theorlangur/smart_watering/pcb/tps61089_layout_example.png

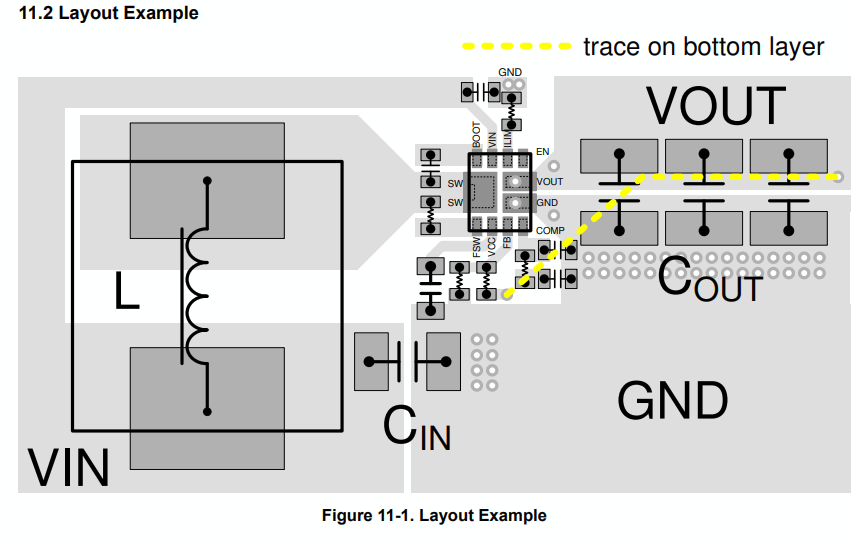
pcb/tps61089_layout_example.png
