theorlangur/smart_watering/pcb/usb-to-uart_swd.png

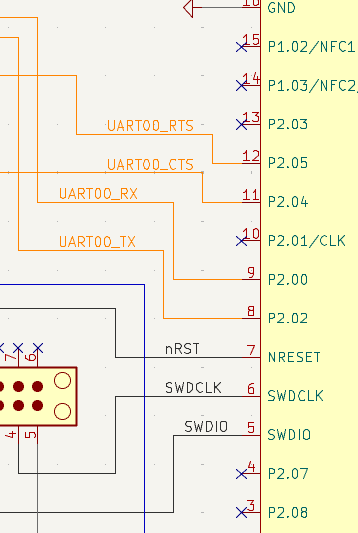
pcb/usb-to-uart_swd.png
