theorlangur/smart_watering/pcb/production/bom.csv

Designator | Footprint | Quantity | Value | LCSC Part #
AEM_CONN_DATA1, AEM_CONN_PWR1 | JST_PH_B6B-PH-K_1x06_P2.00mm_Vertical | 2 | Conn_01x06
AEM_USB_J1 | JST_PH_B2B-PH-K_1x02_P2.00mm_Vertical | 1 | Conn_01x02
BAT_C1, BOOST_9V_C4, BTN_C1, BTN_C2, BTN_C3, MCU_C2 | 0805 | 6 | 100nF
BAT_IC1 | S-82A1A | 1 | S-82A1AAG-I6T1U
BAT_J1 | JST_PH_B2B-PH-K_1x02_P2.00mm_Vertical | 1 | BAT 18650x2
BAT_Q1 | CSD83325L | 1 | CSD83325L
BAT_R1 | 0805 | 1 | 330_O
BAT_R2 | 0805 | 1 | 470_O
BAT_R3 | 0805 | 1 | 5mO
BOOST_9V_C1, BOOST_9V_C2 | 0805 | 2 | 22u
BOOST_9V_C3 | 0805 | 1 | 2.2uF
BOOST_9V_C5 | 0805 | 1 | 4.7nF
BOOST_9V_C6, BOOST_9V_C7, BOOST_9V_C8 | 0805 | 3 | 22uF
BOOST_9V_L1 | IND_EXLA1V0606_EAT | 1 | 1.8uH
BOOST_9V_R1 | 0805 | 1 | 681kO
BOOST_9V_R2 | 0805 | 1 | 107kO
BOOST_9V_R3 | 0805 | 1 | 301kO
BOOST_9V_R4 | 0805 | 1 | 127kO
BOOST_9V_R5 | 0805 | 1 | 17.4kO
BOOST_IC1 | TPS61089 | 1 | TPS61089RNRR
BTN1 | JST_PH_B2B-PH-K_1x02_P2.00mm_Vertical | 1 | Boot
BTN2 | JST_PH_B2B-PH-K_1x02_P2.00mm_Vertical | 1 | ZB
BTN3 | JST_PH_B2B-PH-K_1x02_P2.00mm_Vertical | 1 | CTRL
BTN_R1, BTN_R2, BTN_R3, PUMP_R2, PUMP_R3, UART_R1, UART_R2, USB_R4 | 0805 | 8 | 1kO
IC1 | LDL1117S33R | 1 | LDL1117S33R
MCU_C1, PRESSURE_C1, USB_C1, USB_C2 | 0805 | 4 | 10uF
MCU_IC1 | Laird, BL54L15 Module, Platform Side | 1 | ezurio_bl54l15_453-00001R
MCU_Y1 | Wurth-XTAL-830050789 | 1 | Wurth 830050789
PRESSURE_C2, SENSE_C1, SENSE_C2, SENSE_C3, UART_C1, UART_C2, USB_C3, USB_C4 | 0805 | 8 | 1uF
PRESSURE_C3, PUMP_C1 | 0805 | 2 | 10nF
PRESSURE_IC1 | LDL1117S50R | 1 | LDL1117S50R
PRESSURE_R1, PRESSURE_R2 | 0805 | 2 | 10kO
PRESSURE_U1 | JST_PH_B3B-PH-K_1x03_P2.00mm_Vertical | 1 | ~
PUMP_R1, USB_R3 | 0805 | 2 | 100kO
PUMP_U1 | JST_PH_B5B-PH-K_1x05_P2.00mm_Vertical | 1 | ~
SENSE_LOAD1, SENSE_LOAD2, SENSE_LOAD3 | TPS22917DBVR | 3 | TPS22917DBVR
SENSE_LOAD_QOD1, SENSE_LOAD_QOD2, SENSE_LOAD_QOD3 | 0805 | 3 | 680_O
SENSE_S1 | JST_SH_BM04B-SRSS-TB_1x04-1MP_P1.00mm_Vertical | 1 | ~
SENSE_U2 | JST_PH_B3B-PH-K_1x03_P2.00mm_Vertical | 1 | S1
SENSE_U3 | JST_PH_B3B-PH-K_1x03_P2.00mm_Vertical | 1 | S2
SENSE_U4 | JST_PH_B3B-PH-K_1x03_P2.00mm_Vertical | 1 | S3
SOIL_D1, SOIL_D2, SOIL_D3, USB_D1 | SOT-23-6 | 4 | USBLC6-2SC6
SWD_J1 | IDC Box Header 2x5 1.27 | 1 | IDC Box Header
UART_U1 | MSOP-10_3x3mm_P0.5mm | 1 | CH340E
USB_J1 | USB_C_Receptacle_GCT_USB4105-xx-A_16P_TopMnt_Horizontal | 1 | USB_C_Receptacle_USB2.0_16P
USB_R1, USB_R2 | 0805 | 2 | 5k1_O
