theorlangur/smart_watering/pcb/watering_4layer.csv

Id | Designator | Footprint | Quantity | Designation | Supplier and ref
1 | AEM_CONN_DATA1, AEM_CONN_PWR1 | JST_PH_B6B-PH-K_1x06_P2.00mm_Vertical | 2 | Conn_01x06
2 | AEM_USB_J1 | JST_PH_B2B-PH-K_1x02_P2.00mm_Vertical | 1 | Conn_01x02
3 | BAT_C1, BOOST_9V_C4, BTN_C1, BTN_C2, BTN_C3, MCU_C2 | C_0805_2012Metric | 6 | 100nF
4 | BAT_IC1 | S-82A1A | 1 | S-82A1AAG-I6T1U
5 | BAT_J1 | JST_PH_B2B-PH-K_1x02_P2.00mm_Vertical | 1 | BAT 18650x2
6 | BAT_Q1 | CSD83325L | 1 | CSD83325L
7 | BAT_R1 | R_0805_2012Metric | 1 | 330_O
8 | BAT_R2 | R_0805_2012Metric | 1 | 470_O
9 | BAT_R3 | R_0805_2012Metric | 1 | 5mO
10 | BOOST_9V_C1, BOOST_9V_C2 | C_0805_2012Metric | 2 | 22u
11 | BOOST_9V_C3 | C_0805_2012Metric | 1 | 2.2uF
12 | BOOST_9V_C5 | C_0805_2012Metric | 1 | 4.7nF
13 | BOOST_9V_C6, BOOST_9V_C7, BOOST_9V_C8 | C_0805_2012Metric | 3 | 22uF
14 | BOOST_9V_L1 | IND_EXLA1V0606_EAT | 1 | 1.8uH
15 | BOOST_9V_R1 | R_0805_2012Metric | 1 | 681kO
16 | BOOST_9V_R2 | R_0805_2012Metric | 1 | 107kO
17 | BOOST_9V_R3 | R_0805_2012Metric | 1 | 301kO
18 | BOOST_9V_R4 | R_0805_2012Metric | 1 | 127kO
19 | BOOST_9V_R5 | R_0805_2012Metric | 1 | 17.4kO
20 | BOOST_IC1 | TPS61089 | 1 | TPS61089RNRR
21 | BTN1 | JST_PH_B2B-PH-K_1x02_P2.00mm_Vertical | 1 | Boot
22 | BTN2 | JST_PH_B2B-PH-K_1x02_P2.00mm_Vertical | 1 | ZB
23 | BTN3 | JST_PH_B2B-PH-K_1x02_P2.00mm_Vertical | 1 | CTRL
24 | BTN_R1, BTN_R2, BTN_R3, PUMP_R2, PUMP_R3, UART_R1, UART_R2, USB_R4 | R_0805_2012Metric | 8 | 1kO
25 | IC1 | LDL1117S33R | 1 | LDL1117S33R
26 | MCU_C1, PRESSURE_C1, USB_C1, USB_C2 | C_0805_2012Metric | 4 | 10uF
27 | MCU_IC1 | Laird, BL54L15 Module, Platform Side | 1 | ezurio_bl54l15_453-00001R
28 | MCU_Y1 | Wurth-XTAL-830050789 | 1 | Wurth 830050789
29 | PRESSURE_C2, SENSE_C1, SENSE_C2, SENSE_C3, UART_C1, UART_C2, USB_C3, USB_C4 | C_0805_2012Metric | 8 | 1uF
30 | PRESSURE_C3, PUMP_C1 | C_0805_2012Metric | 2 | 10nF
31 | PRESSURE_IC1 | LDL1117S50R | 1 | LDL1117S50R
32 | PRESSURE_R1, PRESSURE_R2 | R_0805_2012Metric | 2 | 10kO
33 | PRESSURE_U1 | JST_PH_B3B-PH-K_1x03_P2.00mm_Vertical | 1 | ~
34 | PUMP_R1, USB_R3 | R_0805_2012Metric | 2 | 100kO
35 | PUMP_U1 | JST_PH_B5B-PH-K_1x05_P2.00mm_Vertical | 1 | ~
36 | SENSE_LOAD1, SENSE_LOAD2, SENSE_LOAD3 | TPS22917DBVR | 3 | TPS22917DBVR
37 | SENSE_LOAD_QOD1, SENSE_LOAD_QOD2, SENSE_LOAD_QOD3 | R_0805_2012Metric | 3 | 680_O
38 | SENSE_S1 | JST_SH_BM04B-SRSS-TB_1x04-1MP_P1.00mm_Vertical | 1 | ~
39 | SENSE_U2 | JST_PH_B3B-PH-K_1x03_P2.00mm_Vertical | 1 | S1
40 | SENSE_U3 | JST_PH_B3B-PH-K_1x03_P2.00mm_Vertical | 1 | S2
41 | SENSE_U4 | JST_PH_B3B-PH-K_1x03_P2.00mm_Vertical | 1 | S3
42 | SOIL_D1, SOIL_D2, SOIL_D3, USB_D1 | SOT-23-6 | 4 | USBLC6-2SC6
43 | SWD_J1 | IDC Box Header 2x5 1.27 | 1 | IDC Box Header
44 | UART_U1 | MSOP-10_3x3mm_P0.5mm | 1 | CH340E
45 | USB_J1 | USB_C_Receptacle_GCT_USB4105-xx-A_16P_TopMnt_Horizontal | 1 | USB_C_Receptacle_USB2.0_16P
46 | USB_R1, USB_R2 | R_0805_2012Metric | 2 | 5k1_O
