theorlangur/smart_watering/pcb/board_back.pdf

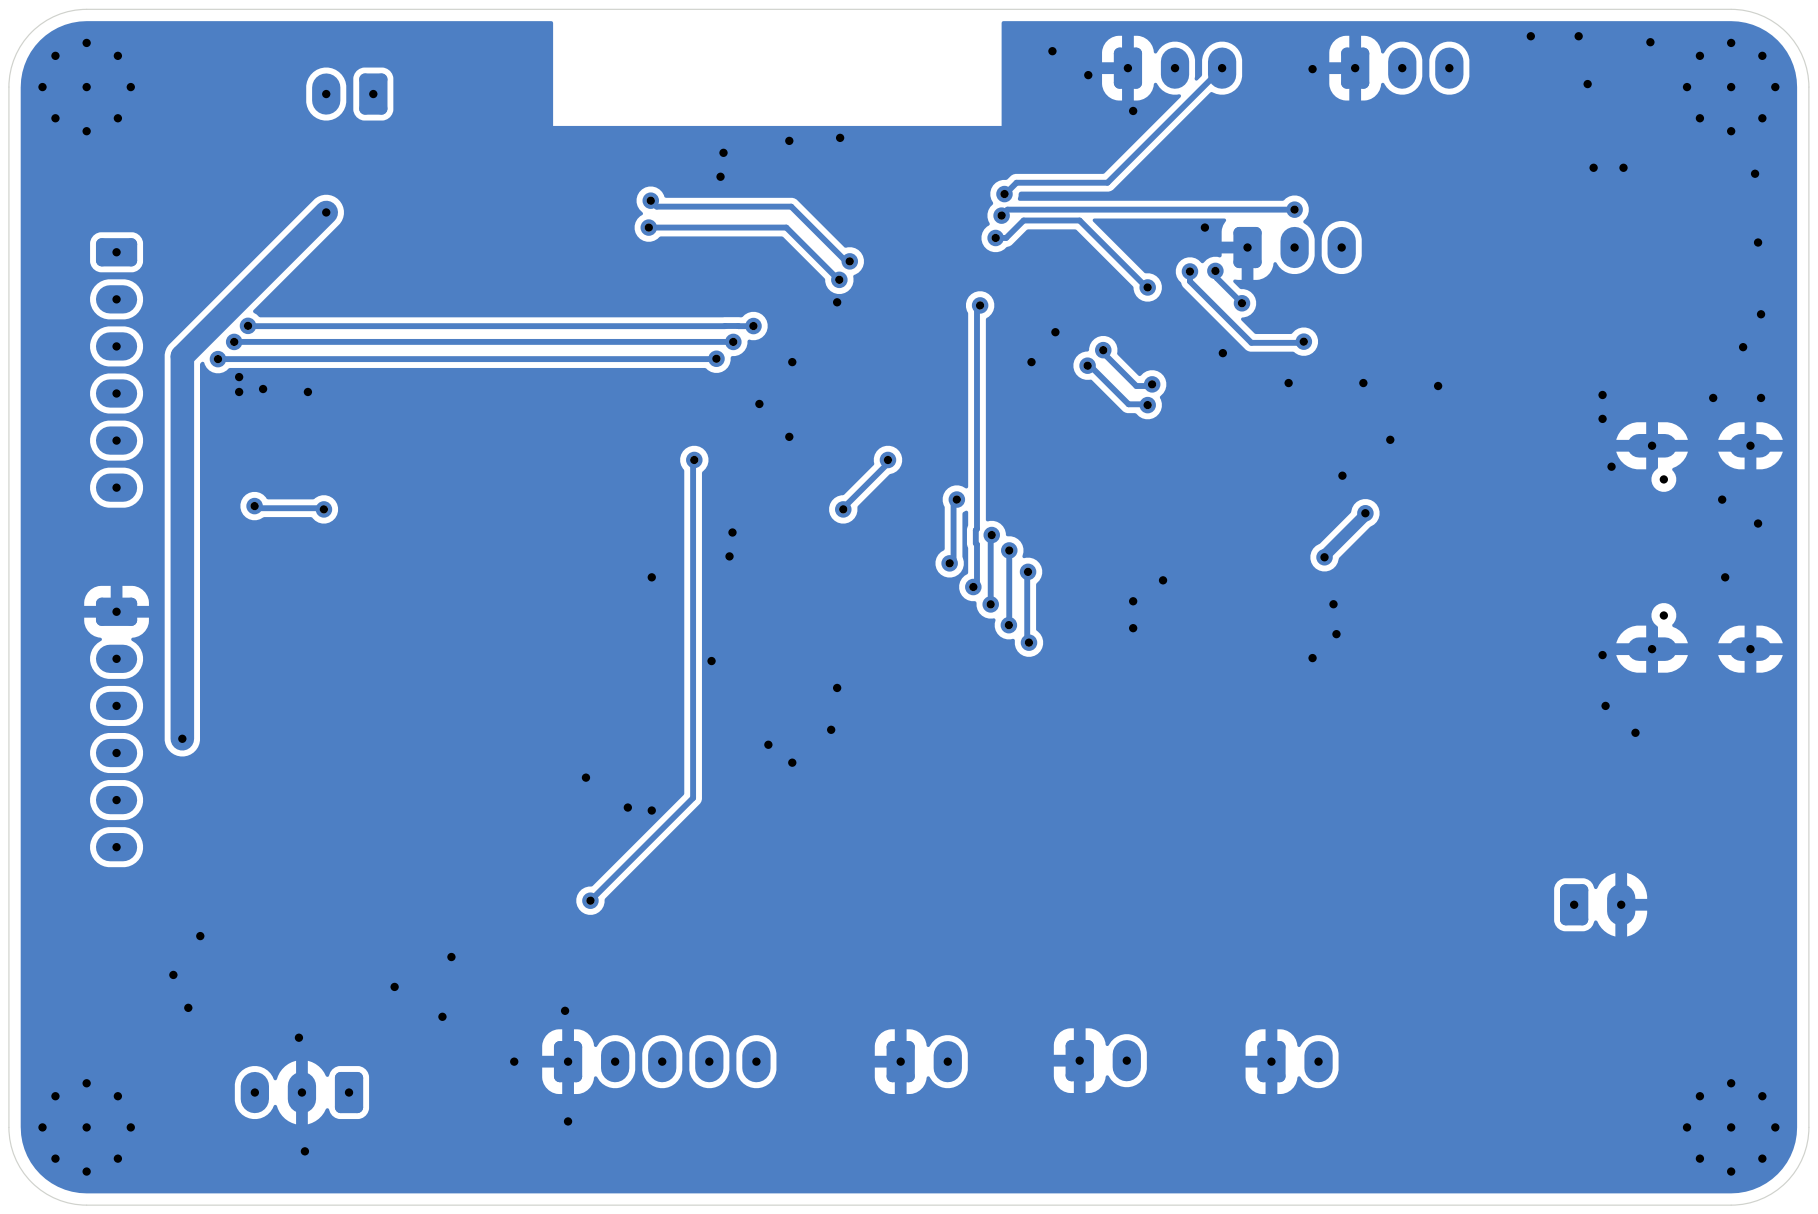
[picture p3: page 1]
