theorlangur/smart_watering/pcb/board_front.pdf

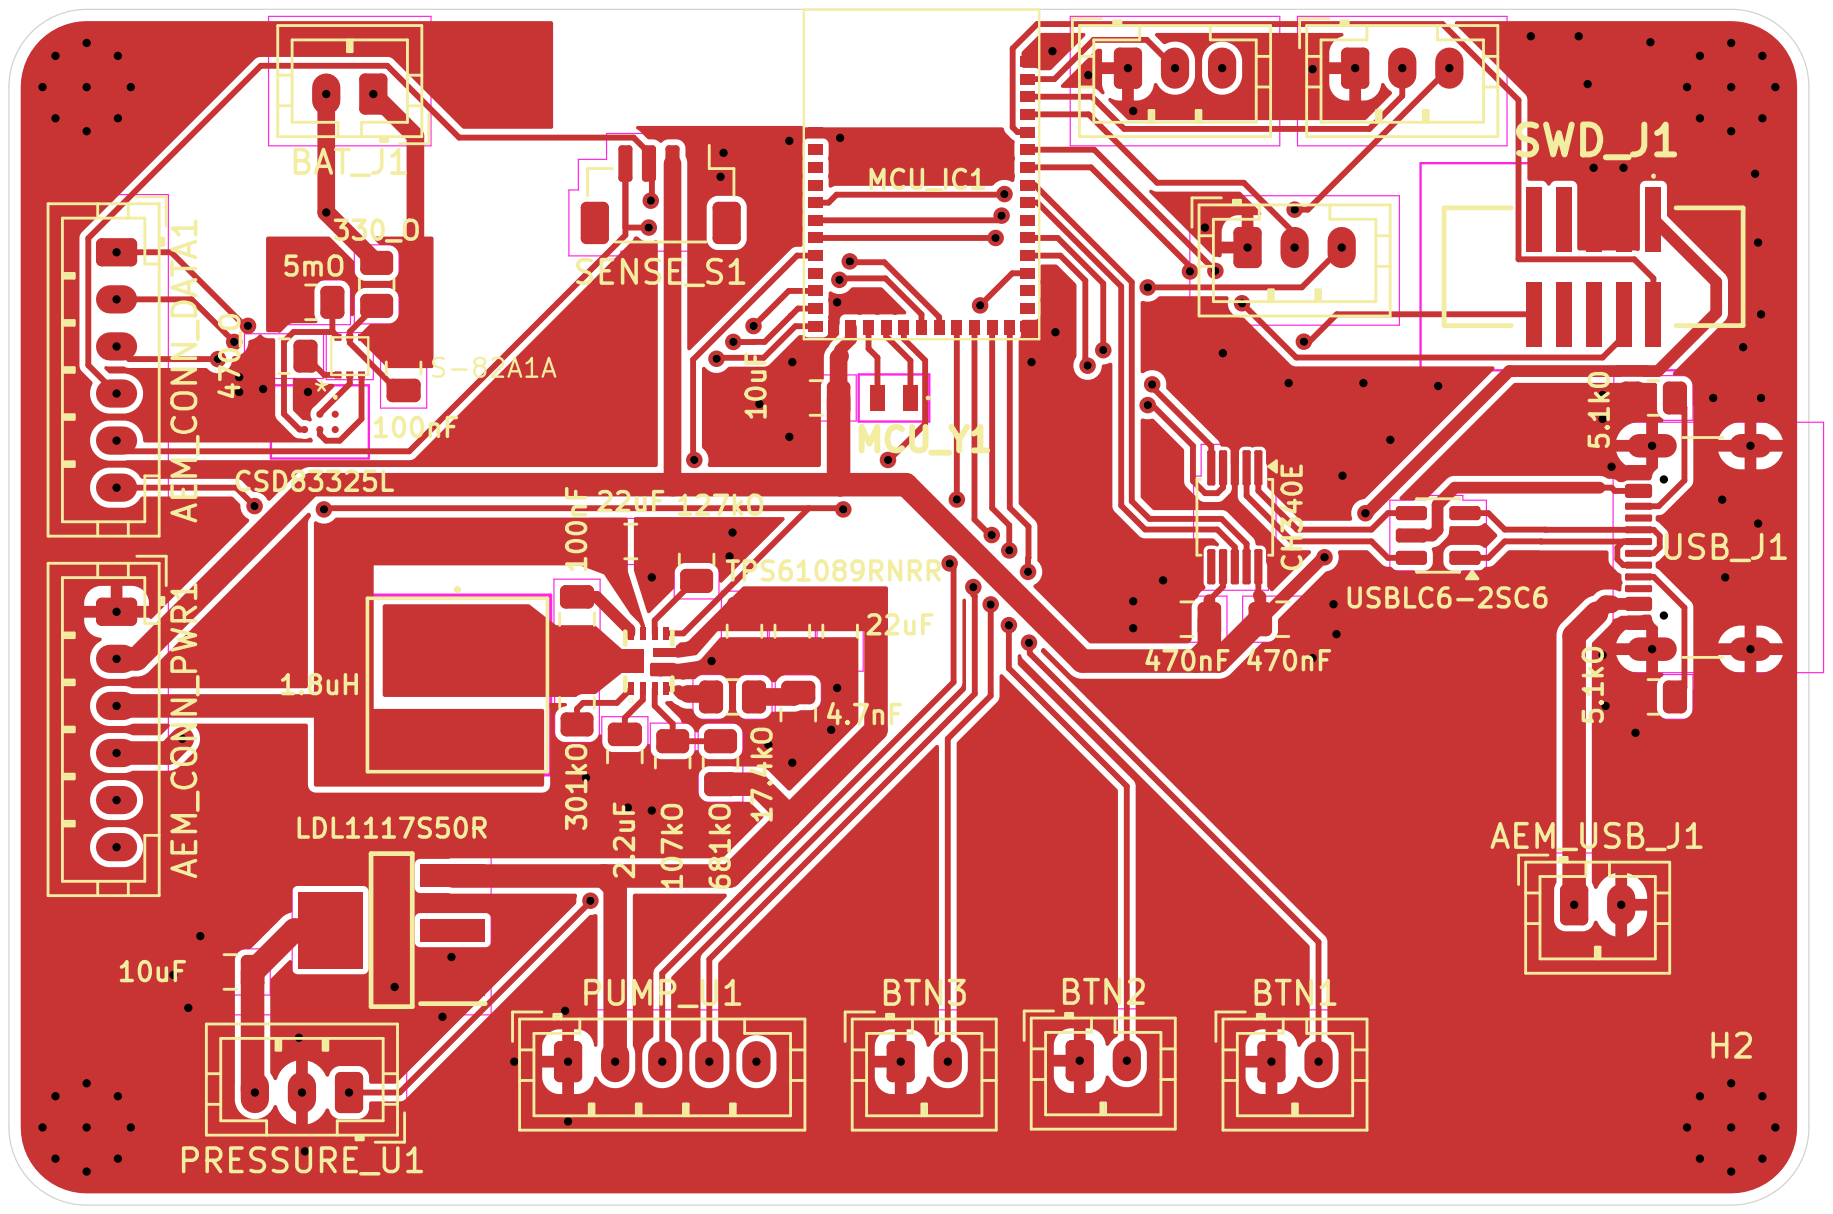
[picture p4: page 1]
