theorlangur/smart_watering/pcb/watering_4layer.kicad_pcb

## KiCad design pcb/watering_4layer.kicad_pcb (2026-09-22)

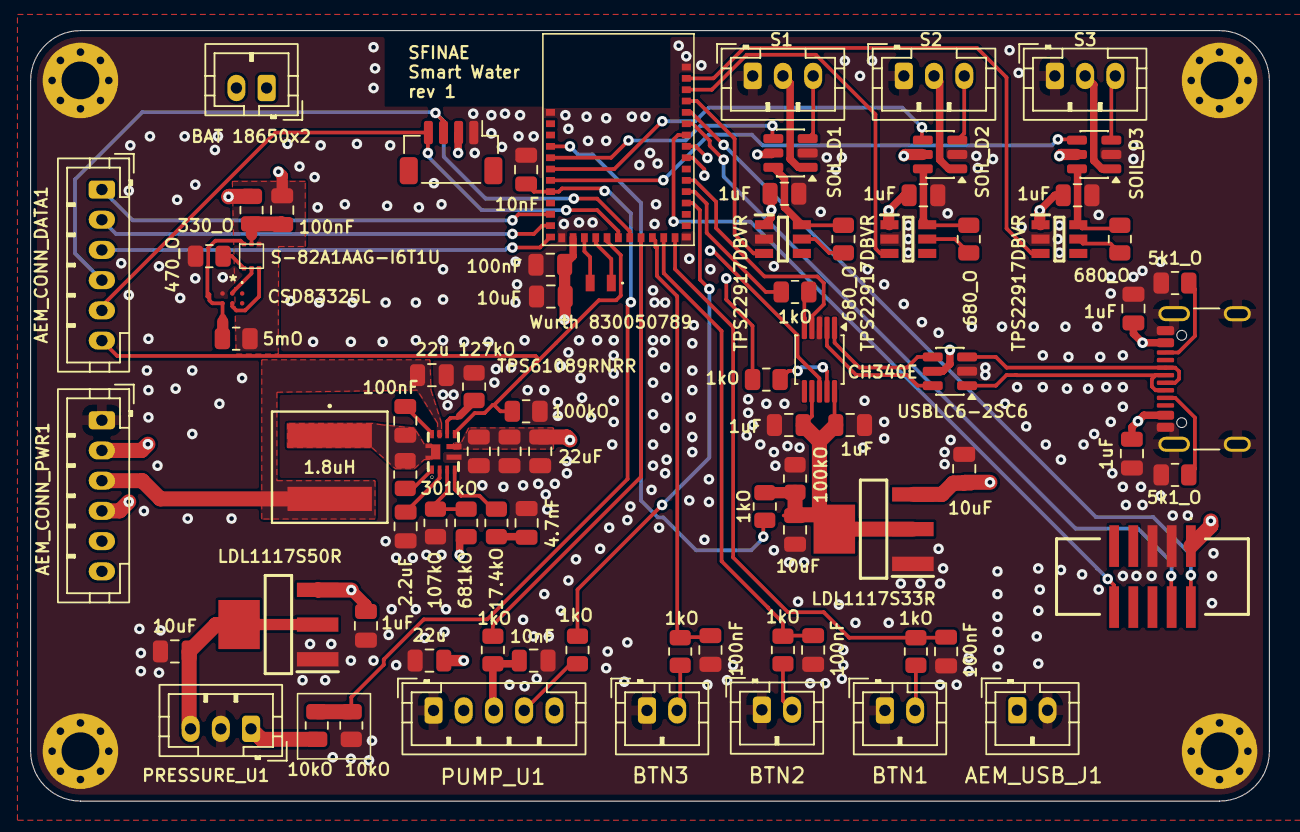
[picture p5: board watering_4layer.kicad_pcb from above]

Board: 4 copper layers, 82.0 x 51.0 mm, 87 parts (0 on the bottom side), 76 nets.

Parts:
AEM_CONN_DATA1: Conn_01x06; JST_PH_B6B-PH-K_1x06_P2.00mm_Vertical
AEM_CONN_PWR1: Conn_01x06; JST_PH_B6B-PH-K_1x06_P2.00mm_Vertical
AEM_USB_J1: Conn_01x02; JST_PH_B2B-PH-K_1x02_P2.00mm_Vertical
BAT_C1: 100nF; C_0805_2012Metric
BAT_IC1: S-82A1AAG-I6T1U; S-82A1A
BAT_J1: BAT 18650x2; JST_PH_B2B-PH-K_1x02_P2.00mm_Vertical
BAT_Q1: CSD83325L
BAT_R1: 330_O; R_0805_2012Metric
BAT_R2: 470_O; R_0805_2012Metric
BAT_R3: 5mO; R_0805_2012Metric
BOOST_9V_C1, BOOST_9V_C2: 22u; C_0805_2012Metric
BOOST_9V_C3: 2.2uF; C_0805_2012Metric
BOOST_9V_C4: 100nF; C_0805_2012Metric
BOOST_9V_C5: 4.7nF; C_0805_2012Metric
BOOST_9V_C6, BOOST_9V_C7, BOOST_9V_C8: 22uF; C_0805_2012Metric
BOOST_9V_L1: 1.8uH; IND_EXLA1V0606_EAT
BOOST_9V_R1: 681kO; R_0805_2012Metric
BOOST_9V_R2: 107kO; R_0805_2012Metric
BOOST_9V_R3: 301kO; R_0805_2012Metric
BOOST_9V_R4: 127kO; R_0805_2012Metric
BOOST_9V_R5: 17.4kO; R_0805_2012Metric
BOOST_IC1: TPS61089RNRR; TPS61089
BTN1: Boot; JST_PH_B2B-PH-K_1x02_P2.00mm_Vertical
BTN2: ZB; JST_PH_B2B-PH-K_1x02_P2.00mm_Vertical
BTN3: CTRL; JST_PH_B2B-PH-K_1x02_P2.00mm_Vertical
BTN_C1, BTN_C2, BTN_C3: 100nF; C_0805_2012Metric
BTN_R1, BTN_R2, BTN_R3: 1kO; R_0805_2012Metric
H1, H2, H3, H4: MountingHole; MountingHole_2.5mm_Pad_Via
IC1: LDL1117S33R
MCU_C1: 10uF; C_0805_2012Metric
MCU_C2: 100nF; C_0805_2012Metric
MCU_IC1: ezurio_bl54l15_453-00001R; Laird, BL54L15 Module, Platform Side
MCU_Y1: Wurth 830050789; Wurth-XTAL-830050789
PRESSURE_C1: 10uF; C_0805_2012Metric
PRESSURE_C2: 1uF; C_0805_2012Metric
PRESSURE_C3: 10nF; C_0805_2012Metric
PRESSURE_IC1: LDL1117S50R
PRESSURE_R1, PRESSURE_R2: 10kO; R_0805_2012Metric
PRESSURE_U1: JST_PH_B3B-PH-K_1x03_P2.00mm_Vertical
PUMP_C1: 10nF; C_0805_2012Metric
PUMP_R1: 100kO; R_0805_2012Metric
PUMP_R2, PUMP_R3: 1kO; R_0805_2012Metric
PUMP_U1: JST_PH_B5B-PH-K_1x05_P2.00mm_Vertical
SENSE_C1, SENSE_C2, SENSE_C3: 1uF; C_0805_2012Metric
SENSE_LOAD1, SENSE_LOAD2, SENSE_LOAD3: TPS22917DBVR
SENSE_LOAD_QOD1, SENSE_LOAD_QOD2, SENSE_LOAD_QOD3: 680_O; R_0805_2012Metric
SENSE_S1: JST_SH_BM04B-SRSS-TB_1x04-1MP_P1.00mm_Vertical
SENSE_U2: S1; JST_PH_B3B-PH-K_1x03_P2.00mm_Vertical
SENSE_U3: S2; JST_PH_B3B-PH-K_1x03_P2.00mm_Vertical
SENSE_U4: S3; JST_PH_B3B-PH-K_1x03_P2.00mm_Vertical
SOIL_D1, SOIL_D2, SOIL_D3: USBLC6-2SC6; SOT-23-6
SWD_J1: IDC Box Header; IDC Box Header 2x5 1.27
UART_C1, UART_C2: 1uF; C_0805_2012Metric
UART_R1, UART_R2: 1kO; R_0805_2012Metric
UART_U1: CH340E; MSOP-10_3x3mm_P0.5mm
USB_C1, USB_C2: 10uF; C_0805_2012Metric
USB_C3, USB_C4: 1uF; C_0805_2012Metric
USB_D1: USBLC6-2SC6; SOT-23-6
USB_J1: USB_C_Receptacle_USB2.0_16P; USB_C_Receptacle_GCT_USB4105-xx-A_16P_TopMnt_Horizontal
USB_R1, USB_R2: 5k1_O; R_0805_2012Metric
USB_R3: 100kO; R_0805_2012Metric
USB_R4: 1kO; R_0805_2012Metric

Connections:
+3V3: AEM_CONN_PWR1.2, MCU_C1.1, MCU_C2.1, MCU_IC1.26 (VDD_NRF), SENSE_C1.2, SENSE_C2.2, SENSE_C3.2, SENSE_LOAD1.1 (VIN), SENSE_LOAD2.1 (VIN), SENSE_LOAD3.1 (VIN), SENSE_S1.2 (VCC), SOIL_D1.5 (VBUS), SOIL_D2.5 (VBUS), SOIL_D3.5 (VBUS), SWD_J1.1
+4V2: AEM_CONN_PWR1.3, BOOST_9V_C1.1, BOOST_9V_L1.2, BOOST_IC1.9 (VIN)
+5V: PRESSURE_C1.1, PRESSURE_IC1.2 (VOUT_1), PRESSURE_IC1.4 (VOUT_2), PRESSURE_U1.3 (VCC)
+9V: BOOST_9V_C2.1, BOOST_9V_C6.1, BOOST_9V_C7.1, BOOST_9V_C8.1, BOOST_9V_R1.1, BOOST_IC1.6 (VOUT), PRESSURE_C2.1, PRESSURE_IC1.3 (VIN), PUMP_U1.2 (VCC)
+VBUS: AEM_USB_J1.1, IC1.3 (VIN), USB_C1.2, USB_C3.2, USB_C4.2, USB_D1.5 (VBUS), USB_J1.A4 (VBUS), USB_J1.A9 (VBUS), USB_J1.B4 (VBUS), USB_J1.B9 (VBUS)
/AEM_IRQ: AEM_CONN_DATA1.3, MCU_IC1.28 (P1.10)
/AEM_LOAD: AEM_CONN_DATA1.1, MCU_IC1.30 (P1.08/EXTREF/CLK16M/_CLK)
/AEM_PWR_STO: AEM_CONN_PWR1.4, BAT_J1.2, BAT_R1.1
/AEM_STO: AEM_CONN_DATA1.2, MCU_IC1.29 (P1.09)
/BOOST_9V_SW: BOOST_9V_C4.1, BOOST_9V_L1.1, BOOST_9V_R3.1, BOOST_IC1.11 (SW)
/BTN_BOOT: BTN_C1.1, BTN_R1.2, MCU_IC1.17 (P0.00_)
/BTN_CTRL: BTN_C3.1, BTN_R3.2, MCU_IC1.19 (P0.02)
/BTN_ZB: BTN_C2.1, BTN_R2.2, MCU_IC1.18 (P0.01_)
/I2C_SDA: AEM_CONN_DATA1.4, MCU_IC1.21 (P1.06/AIN2), SENSE_S1.3 (SDA)
/I2C_SDC: AEM_CONN_DATA1.5, MCU_IC1.22 (P1.05/AIN1_), SENSE_S1.4 (SDC)
/PRESSURE_OUT: PRESSURE_R1.2, PRESSURE_U1.1 (OUT)
/PUMP_OUT: PUMP_C1.1, PUMP_R2.1, PUMP_U1.3 (OUT)
/PUMP_POWER_CTRL: AEM_CONN_DATA1.6, BOOST_IC1.7 (EN), MCU_IC1.23 (P1.04/AIN0/CLK), PUMP_R1.2
/PUMP_PWM: PUMP_R3.1, PUMP_U1.4 (PWM)
/SOIL1_OUT: MCU_IC1.35 (P1.11/AIN4/CLK), SOIL_D1.4 (I/O2)
/SOIL1_VCC: MCU_IC1.4 (P2.07), SENSE_LOAD1.3 (ON)
/SOIL2_OUT: MCU_IC1.34 (P1.12/AIN5/CLK), SOIL_D2.4 (I/O2)
/SOIL2_VCC: MCU_IC1.3 (P2.08), SENSE_LOAD2.3 (ON)
/SOIL3_OUT: MCU_IC1.33 (P1.13/AIN6), SOIL_D3.4 (I/O2)
/SOIL3_VCC: MCU_IC1.2 (P2.09), SENSE_LOAD3.3 (ON)
/SWDCLK: MCU_IC1.6 (SWDCLK), SWD_J1.4
/SWDIO: MCU_IC1.5 (SWDIO), SWD_J1.2
/UART00_CTS: MCU_IC1.11 (P2.04), UART_U1.4 (~RTS)
/UART00_RTS: UART_R2.2, UART_U1.5 (~CTS)
/UART00_RX: MCU_IC1.9 (P2.00), UART_U1.8 (TXD)
/UART00_TX: UART_R1.2, UART_U1.9 (RXD)
/USBCD+: USB_D1.3 (I/O2), USB_J1.A6 (D+), USB_J1.B6 (D+)
/USBCD-: USB_D1.1 (I/O1), USB_J1.A7 (D-), USB_J1.B7 (D-)
/USBD+: UART_U1.1 (UD+), USB_D1.4 (I/O2)
/USBD-: UART_U1.2 (UD-), USB_D1.6 (I/O1)
/XL1: MCU_IC1.25 (P1.00/XL1_), MCU_Y1.2
/XL2: MCU_IC1.24 (P1.01/XL2_), MCU_Y1.1
/nRST: MCU_IC1.7 (NRESET), SWD_J1.10
BATT_GND: BAT_C1.2, BAT_IC1.4 (VSS), BAT_J1.1, BAT_R3.1
GND: AEM_CONN_PWR1.1, AEM_USB_J1.2, BAT_Q1.C1 (S1_2), BAT_R2.2, BOOST_9V_C1.2, BOOST_9V_C2.2, BOOST_9V_C3.2, BOOST_9V_C5.2, BOOST_9V_C6.2, BOOST_9V_C7.2, BOOST_9V_C8.2, BOOST_9V_R2.2, BOOST_9V_R4.2, BOOST_IC1.5 (GND), BTN1.1, BTN2.1, BTN3.1, BTN_C1.2, BTN_C2.2, BTN_C3.2, H1.1 (1_1), H2.1 (1_1), H3.1 (1_1), H4.1 (1_1), IC1.1 (GND), MCU_C1.2, MCU_C2.2, MCU_IC1.1 (GND_1), MCU_IC1.16 (GND_2), MCU_IC1.27 (GND_3), MCU_IC1.39 (GND_4), PRESSURE_C1.2, PRESSURE_C2.2, PRESSURE_C3.2, PRESSURE_IC1.1 (GND), PRESSURE_R2.1, PRESSURE_U1.2 (GND), PUMP_C1.2, PUMP_R1.1, PUMP_U1.1 (GND), SENSE_C1.1, SENSE_C2.1, SENSE_C3.1, SENSE_LOAD1.2 (GND), SENSE_LOAD2.2 (GND), SENSE_LOAD3.2 (GND), SENSE_S1.1 (GND), SENSE_U2.1 (GND), SENSE_U3.1 (GND), SENSE_U4.1 (GND), SOIL_D1.2 (GND), SOIL_D2.2 (GND), SOIL_D3.2 (GND), SWD_J1.3, SWD_J1.5, UART_C1.2, UART_C2.2, UART_U1.3 (GND), USB_C1.1, USB_C2.2, USB_C3.1, USB_C4.1, USB_D1.2 (GND), USB_J1.A1 (GND), USB_J1.A12 (GND), USB_J1.B1 (GND), USB_J1.B12 (GND), USB_J1.SH (SHIELD), USB_R1.2, USB_R2.2, USB_R3.2
unnamed: BAT_IC1.2 (CO), BAT_Q1.B1 (G1)
unnamed: BAT_IC1.3 (DO), BAT_Q1.B2 (G2)
unnamed: BAT_C1.1, BAT_IC1.5 (VDD), BAT_R1.2
unnamed: BAT_IC1.6 (VINI), BAT_Q1.C2 (S2_2), BAT_R3.2
unnamed: BAT_IC1.1 (VM), BAT_R2.1
unnamed: BOOST_9V_C5.1, BOOST_9V_R5.1
unnamed: BOOST_9V_C4.2, BOOST_IC1.10 (BOOT)
unnamed: BOOST_9V_R5.2, BOOST_IC1.4 (COMP)
unnamed: BOOST_9V_R1.2, BOOST_9V_R2.1, BOOST_IC1.3 (FB)
unnamed: BOOST_9V_R3.2, BOOST_IC1.1 (FSW)
unnamed: BOOST_9V_R4.1, BOOST_IC1.8 (ILIM)
unnamed: BOOST_9V_C3.1, BOOST_IC1.2 (VCC)
unnamed: BTN1.2, BTN_R1.1
unnamed: BTN2.2, BTN_R2.1
unnamed: BTN3.2, BTN_R3.1
unnamed: MCU_IC1.36 (P0.03/CLK), USB_R4.1
unnamed: MCU_IC1.20 (P1.07/AIN3), PUMP_R2.2
unnamed: MCU_IC1.32 (P1.14/AIN7), PRESSURE_C3.1, PRESSURE_R1.1, PRESSURE_R2.2
unnamed: MCU_IC1.8 (P2.02_), UART_R1.1
unnamed: MCU_IC1.13 (P2.03), PUMP_R3.2
unnamed: MCU_IC1.12 (P2.05), UART_R2.1
unnamed: SENSE_LOAD1.5 (QOD), SENSE_LOAD_QOD1.1
unnamed: SENSE_LOAD1.6 (VOUT), SENSE_LOAD_QOD1.2, SOIL_D1.6 (I/O1)
unnamed: SENSE_LOAD2.5 (QOD), SENSE_LOAD_QOD2.1
unnamed: SENSE_LOAD2.6 (VOUT), SENSE_LOAD_QOD2.2, SOIL_D2.6 (I/O1)
unnamed: SENSE_LOAD3.5 (QOD), SENSE_LOAD_QOD3.1
unnamed: SENSE_LOAD3.6 (VOUT), SENSE_LOAD_QOD3.2, SOIL_D3.6 (I/O1)
unnamed: SENSE_U2.3 (OUT), SOIL_D1.3 (I/O2)
unnamed: SENSE_U2.2 (VCC), SOIL_D1.1 (I/O1)
unnamed: SENSE_U3.3 (OUT), SOIL_D2.3 (I/O2)
unnamed: SENSE_U3.2 (VCC), SOIL_D2.1 (I/O1)
unnamed: SENSE_U4.3 (OUT), SOIL_D3.3 (I/O2)
unnamed: SENSE_U4.2 (VCC), SOIL_D3.1 (I/O1)
unnamed: USB_J1.A5 (CC1), USB_R2.1
unnamed: USB_J1.B5 (CC2), USB_R1.1
USB_3.3V: IC1.2 (VOUT_1), IC1.4 (VOUT_2), UART_C1.1, UART_C2.1, UART_U1.7 (VCC), UART_U1.10 (V3), USB_C2.1, USB_R3.1, USB_R4.2
