theorlangur/smart_watering/pcb/watering.kicad_pcb

## KiCad design pcb/watering.kicad_pcb (2026-09-22)

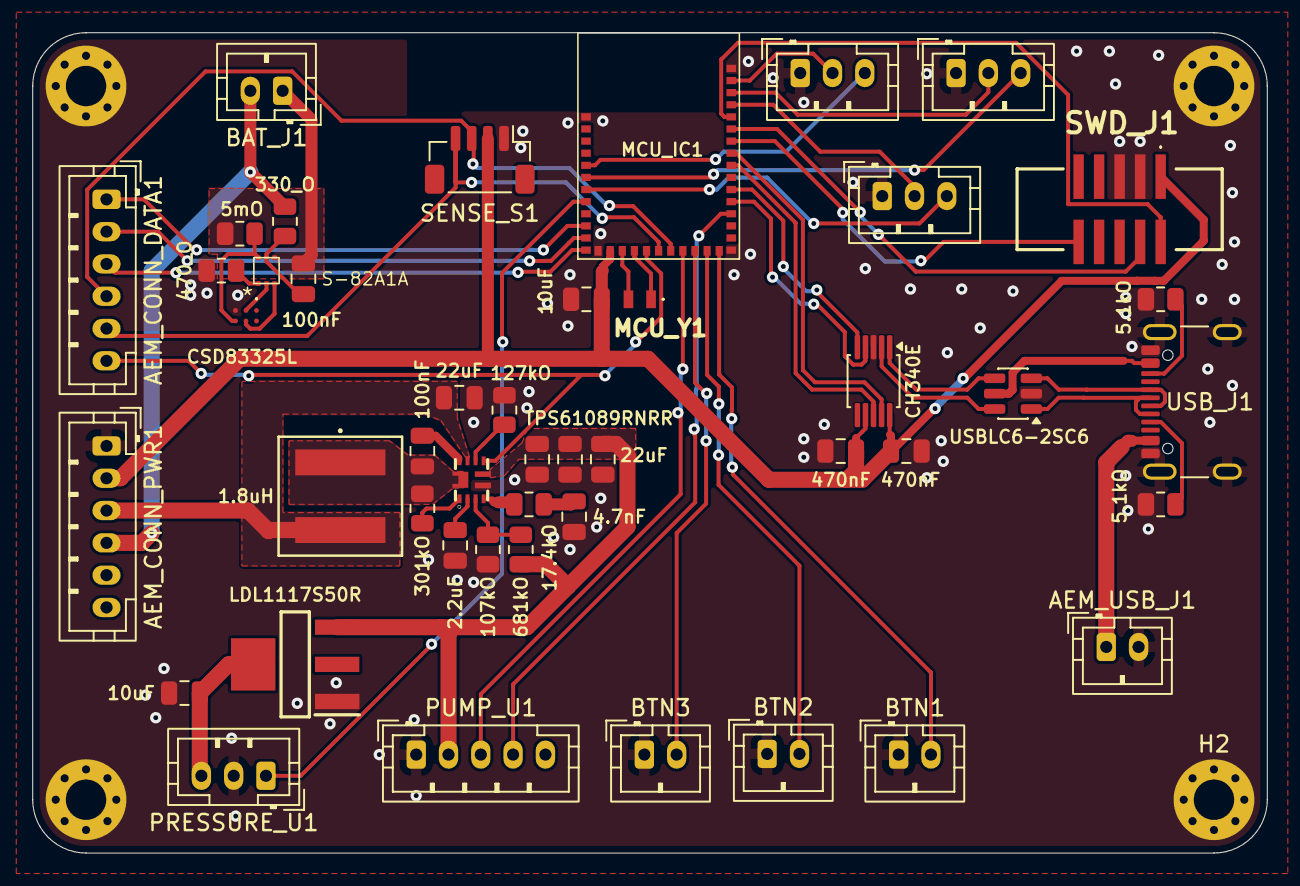
[picture p6: board watering.kicad_pcb from above]

Board: 2 copper layers, 76.5 x 50.8 mm, 50 parts (0 on the bottom side), 54 nets.

Parts:
1.8uH: 1.8uH; IND_EXLA1V0606_EAT
2.2uF: 2.2u; C_0805_2012Metric
4.7nF: 4.7n; C_0805_2012Metric
5.1kO, 5.1kO#2: 5k1; R_0805_2012Metric
5mO: 5mO; R_0805_2012Metric
10uF, 10uF#2: 10u; C_0805_2012Metric
17.4kO: 17.4k; R_0805_2012Metric
22uF, 22uF#2: 22u; C_0805_2012Metric
100nF, 100nF#2: 100n; C_0805_2012Metric
107kO: 107k; R_0805_2012Metric
127kO: 127k; R_0805_2012Metric
301kO: 301k; R_0805_2012Metric
330_O: 330; R_0805_2012Metric
470_O: 470; R_0805_2012Metric
470nF, 470nF#2: 470n; C_0805_2012Metric
681kO: 681k; R_0805_2012Metric
AEM_CONN_DATA1: Conn_01x06; JST_PH_B6B-PH-K_1x06_P2.00mm_Vertical
AEM_CONN_PWR1: Conn_01x06; JST_PH_B6B-PH-K_1x06_P2.00mm_Vertical
AEM_USB_J1: Conn_01x02; JST_PH_B2B-PH-K_1x02_P2.00mm_Vertical
BAT_J1: BAT 18650x2; JST_PH_B2B-PH-K_1x02_P2.00mm_Vertical
BOOST_9V_C6, BOOST_9V_C7: 22u; C_0805_2012Metric
BTN1: Boot; JST_PH_B2B-PH-K_1x02_P2.00mm_Vertical
BTN2: ZB; JST_PH_B2B-PH-K_1x02_P2.00mm_Vertical
BTN3: CTRL; JST_PH_B2B-PH-K_1x02_P2.00mm_Vertical
CH340E: CH340E; MSOP-10_3x3mm_P0.5mm
CSD83325L: CSD83325L
H1, H2, H3, H4: MountingHole; MountingHole_2.5mm_Pad_Via
LDL1117S50R: LDL1117S50R
MCU_IC1: ezurio_bl54l15_453-00001R; Laird, BL54L15 Module, Platform Side
MCU_Y1: Wurth 830050789; Wurth-XTAL-830050789
PRESSURE_U1: JST_PH_B3B-PH-K_1x03_P2.00mm_Vertical
PUMP_U1: JST_PH_B5B-PH-K_1x05_P2.00mm_Vertical
S-82A1A: S-82A1AAG-I6T1U; S-82A1A
SENSE_S1: JST_SH_BM04B-SRSS-TB_1x04-1MP_P1.00mm_Vertical
SENSE_U2, SENSE_U3, SENSE_U4: JST_PH_B3B-PH-K_1x03_P2.00mm_Vertical
SWD_J1: IDC Box Header; IDC Box Header 2x5 1.27
TPS61089RNRR: TPS61089RNRR; TPS61089
USBLC6-2SC6: USBLC6-2SC6; SOT-23-6
USB_J1: USB_C_Receptacle_USB2.0_16P; USB_C_Receptacle_GCT_USB4105-xx-A_16P_TopMnt_Horizontal

Connections:
+3V3: 10uF.1, 470nF.1, 470nF#2.1, AEM_CONN_PWR1.2, CH340E.7 (VCC), CH340E.10 (V3), MCU_IC1.26 (VDD_NRF), SENSE_S1.2 (VCC), SWD_J1.1
+4V2: 1.8uH.2, 22uF#2.1, AEM_CONN_PWR1.3, TPS61089RNRR.9 (VIN)
+5V: 10uF#2.1, LDL1117S50R.4 (VOUT_2), PRESSURE_U1.3 (VCC)
+9V: 22uF.1, 681kO.1, BOOST_9V_C6.1, BOOST_9V_C7.1, LDL1117S50R.3 (VIN), PUMP_U1.2 (VCC), TPS61089RNRR.6 (VOUT)
+VBUS: AEM_USB_J1.1, USBLC6-2SC6.5 (VBUS), USB_J1.A4 (VBUS), USB_J1.A9 (VBUS), USB_J1.B4 (VBUS), USB_J1.B9 (VBUS)
/AEM_IRQ: AEM_CONN_DATA1.3, MCU_IC1.28 (P1.10)
/AEM_LOAD: AEM_CONN_DATA1.1, MCU_IC1.30 (P1.08/EXTREF/CLK16M/_CLK)
/AEM_PWR_STO: 330_O.1, AEM_CONN_PWR1.4, BAT_J1.2
/AEM_STO: AEM_CONN_DATA1.2, MCU_IC1.29 (P1.09)
/BOOST_9V_SW: 1.8uH.1, 100nF.1, 301kO.1, TPS61089RNRR.11 (SW)
/BTN_BOOT: BTN1.2, MCU_IC1.17 (P0.00_)
/BTN_CTRL: BTN3.2, MCU_IC1.19 (P0.02)
/BTN_ZB: BTN2.2, MCU_IC1.18 (P0.01_)
/I2C_SDA: AEM_CONN_DATA1.4, MCU_IC1.21 (P1.06/AIN2), SENSE_S1.3 (SDA)
/I2C_SDC: AEM_CONN_DATA1.5, MCU_IC1.22 (P1.05/AIN1_), SENSE_S1.4 (SDC)
/PRESSURE_OUT: MCU_IC1.32 (P1.14/AIN7), PRESSURE_U1.1 (OUT)
/PUMP_OUT: MCU_IC1.20 (P1.07/AIN3), PUMP_U1.3 (OUT)
/PUMP_POWER_CTRL: AEM_CONN_DATA1.6, MCU_IC1.23 (P1.04/AIN0/CLK), TPS61089RNRR.7 (EN)
/PUMP_PWM: MCU_IC1.13 (P2.03), PUMP_U1.4 (PWM)
/SOIL1_OUT: MCU_IC1.35 (P1.11/AIN4/CLK), SENSE_U2.3 (OUT)
/SOIL1_VCC: MCU_IC1.2 (P2.09), SENSE_U2.2 (VCC)
/SOIL2_OUT: MCU_IC1.34 (P1.12/AIN5/CLK), SENSE_U3.3 (OUT)
/SOIL2_VCC: MCU_IC1.3 (P2.08), SENSE_U3.2 (VCC)
/SOIL3_OUT: MCU_IC1.33 (P1.13/AIN6), SENSE_U4.3 (OUT)
/SOIL3_VCC: MCU_IC1.4 (P2.07), SENSE_U4.2 (VCC)
/SWDCLK: MCU_IC1.6 (SWDCLK), SWD_J1.4
/SWDIO: MCU_IC1.5 (SWDIO), SWD_J1.2
/UART00_CTS: CH340E.5 (~CTS), MCU_IC1.11 (P2.04)
/UART00_RTS: CH340E.4 (~RTS), MCU_IC1.12 (P2.05)
/UART00_RX: CH340E.8 (TXD), MCU_IC1.9 (P2.00)
/UART00_TX: CH340E.9 (RXD), MCU_IC1.8 (P2.02_)
/USBCD+: USBLC6-2SC6.3 (I/O2), USB_J1.A6 (D+), USB_J1.B6 (D+)
/USBCD-: USBLC6-2SC6.1 (I/O1), USB_J1.A7 (D-), USB_J1.B7 (D-)
/USBD+: CH340E.1 (UD+), USBLC6-2SC6.4 (I/O2)
/USBD-: CH340E.2 (UD-), USBLC6-2SC6.6 (I/O1)
/XL1: MCU_IC1.25 (P1.00/XL1_), MCU_Y1.2
/XL2: MCU_IC1.24 (P1.01/XL2_), MCU_Y1.1
/nRST: MCU_IC1.7 (NRESET), SWD_J1.10
BATT_GND: 5mO.1, 100nF#2.2, BAT_J1.1, S-82A1A.4 (VSS)
GND: 2.2uF.2, 4.7nF.2, 5.1kO.2, 5.1kO#2.2, 10uF.2, 10uF#2.2, 22uF.2, 22uF#2.2, 107kO.2, 127kO.2, 470_O.2, 470nF.2, 470nF#2.2, AEM_CONN_PWR1.1, AEM_USB_J1.2, BOOST_9V_C6.2, BOOST_9V_C7.2, BTN1.1, BTN2.1, BTN3.1, CH340E.3 (GND), CSD83325L.C1 (S1_2), H1.1 (1_1), H2.1 (1_1), H3.1 (1_1), H4.1 (1_1), LDL1117S50R.1 (GND), MCU_IC1.1 (GND_1), MCU_IC1.16 (GND_2), MCU_IC1.27 (GND_3), MCU_IC1.39 (GND_4), PRESSURE_U1.2 (GND), PUMP_U1.1 (GND), SENSE_S1.1 (GND), SENSE_U2.1 (GND), SENSE_U3.1 (GND), SENSE_U4.1 (GND), SWD_J1.3, SWD_J1.5, TPS61089RNRR.5 (GND), USBLC6-2SC6.2 (GND), USB_J1.A1 (GND), USB_J1.A12 (GND), USB_J1.B1 (GND), USB_J1.B12 (GND), USB_J1.SH (SHIELD)
unnamed: CSD83325L.B1 (G1), S-82A1A.2 (CO)
unnamed: CSD83325L.B2 (G2), S-82A1A.3 (DO)
unnamed: 100nF#2.1, 330_O.2, S-82A1A.5 (VDD)
unnamed: 5mO.2, CSD83325L.C2 (S2_2), S-82A1A.6 (VINI)
unnamed: 470_O.1, S-82A1A.1 (VM)
unnamed: 4.7nF.1, 17.4kO.1
unnamed: 100nF.2, TPS61089RNRR.10 (BOOT)
unnamed: 17.4kO.2, TPS61089RNRR.4 (COMP)
unnamed: 107kO.1, 681kO.2, TPS61089RNRR.3 (FB)
unnamed: 301kO.2, TPS61089RNRR.1 (FSW)
unnamed: 127kO.1, TPS61089RNRR.8 (ILIM)
unnamed: 2.2uF.1, TPS61089RNRR.2 (VCC)
unnamed: 5.1kO.1, USB_J1.A5 (CC1)
unnamed: 5.1kO#2.1, USB_J1.B5 (CC2)
