theorlangur/smart_watering/src/main.cpp

/*
 * Copyright (c) 2023, Meta
 *
 * SPDX-License-Identifier: Apache-2.0
 */

#include "lib_misc_helpers.hpp"
#define FORCE_FMT
#undef PRINTF_FUNC
#define PRINTF_FUNC(...) printk(__VA_ARGS__)

#include <zephyr/kernel.h>
#include <zephyr/drivers/gpio.h>
#include <zephyr/drivers/i2c.h>
#include <zephyr/settings/settings.h>
//#include <dk_buttons_and_leds.h>
//#include <nrf_general/led.h>

//#include <zephyr/drivers/sensor.h>
//#include <zephyr/drivers/sensor/ens160.h>

#include <zephyr/drivers/hwinfo.h>
#include <zephyr/drivers/watchdog.h>
#include <zephyr/storage/flash_map.h>
#include "usb_uart.hpp"
#include "threads_snapshot.hpp"
#include "partition_basic.hpp"
#include "soil_task.hpp"
#include "pump_and_pressure_task.hpp"
#include "zigbee.hpp"


#include <zephyr/logging/log.h>
#include <zephyr/drivers/sensor/aem13921.hpp>

#include <atomic>

//extern "C"{
//#include <zephyr/debug/coredump.h>
//
//void nrf_flash_skip_sync(bool skip);
//}

constexpr bool kDebug = false;

#define BREADCRUMBS_PARTITION		breadcrumbs_partition
#define BREADCRUMBS_PARTITION_ID	FIXED_PARTITION_ID(BREADCRUMBS_PARTITION)

LOG_MODULE_REGISTER(main_log, LOG_LEVEL_INF);


/**********************************************************************/
/* For testing purposes                                               */
/**********************************************************************/

static const struct gpio_dt_spec btn0 = GPIO_DT_SPEC_GET(DT_NODELABEL(button0), gpios);
static const struct gpio_dt_spec btn1 = GPIO_DT_SPEC_GET(DT_NODELABEL(button1), gpios);
static const struct gpio_dt_spec btn2 = GPIO_DT_SPEC_GET(DT_NODELABEL(button2), gpios);

static const struct gpio_dt_spec aem13921_irq = GPIO_DT_SPEC_GET(DT_NODELABEL(i2c_irq), gpios);

static struct gpio_callback btn0_cb_data;
static struct gpio_callback aem_cb_data;
static struct k_work test_measure_soil_work;

void measure_soil_handler(soil::soil_result_t *pResults, size_t count, uint32_t mask, void *pUserArg)
{
    for(size_t i = 0; i < count; ++i)
    {
	if (mask & (1 << i))
	{
	    auto &r = pResults[i];
	    if (r)
	    {
		LOG_INF("soil%d: %.2f%%", (int)i, double(*r));
	    }else
	    {
		LOG_INF("soil%d: %d (%s)", (int)i, r.error(), strerror(r.error()));
	    }
	}
    }
}

bool dump_aem_info = false;
static struct k_work btn0_work;
static void btn0_work_handler(struct k_work *work)
{
    LOG_INF("button press registered");
    dump_aem_info = true;
}

static void btn0_isr(const struct device *dev, struct gpio_callback *cb, uint32_t pins)
{
    /* Defer PM state change out of interrupt context */
    //soil::run_measurements({.soil_sensors_mask = 0b0111, .callback = measure_soil_handler});
    //pump::command(pump::start_t{.duration = 10000, .power_percentage = 80}, nullptr, nullptr);
    pump::command(pump::pressure_measure_t{}, nullptr, nullptr);
    k_work_submit(&btn0_work);
}


void on_pressure_measured(float level_percentage)
{
    LOG_INF("Received pressure measurement: %.2f", level_percentage);
}

static const struct device *const aem13921_dev = DEVICE_DT_GET(DT_NODELABEL(aem13921));

size_t dbg_dump_aem13921_status(epeas::status_t s, char *buf, size_t sz)
{
    size_t used_len = 0;
    char *p = buf;
    auto add_flag = [&](bool f, std::string_view v)
    {
	if (f && (used_len + v.size() + 1) <= sz)
	{
	    strcpy(p, v.data());
	    p += v.size();
	    used_len += v.size();
	}
    };
    add_flag(s.bits.ovdischarge, "ovdis; ");
    add_flag(s.bits.charge_ready, "chrdy; ");
    add_flag(s.bits.overcharge, "ovch; ");
    add_flag(s.bits.src1_low, "s1low; ");
    add_flag(s.bits.src2_low, "s2low; ");
    add_flag(s.bits.charger_5v_connected, "ch5v; ");
    add_flag(s.bits.temp_cold_charge, "t_cold_ch; ");
    add_flag(s.bits.temp_hot_charge, "t_hot_ch; ");
    add_flag(s.bits.temp_cold_dis, "t_cold_dis; ");
    add_flag(s.bits.temp_hot_discharge, "t_hot_dis; ");
    return used_len;
}

void dbg_aem13921()
{
    LOG_INF("<================AEM13921=================>");
	//   {
	//auto irq = epeas::aem1392x_get_irq_state(aem13921_dev);
	//if (irq)
	//{
	//    LOG_INF("irq: 0x%X 0x%X", (*irq).bytes[0], (*irq).bytes[1]);
	//}else
	//{
	//    LOG_ERR("irq: failed with %d %s", irq.error(), strerror(irq.error()));
	//}
	//   }
    {
	auto status = epeas::aem1392x_get_status(aem13921_dev);
	if (status)
	{
	    char buf[128]={0};
	    dbg_dump_aem13921_status(*status, buf, sizeof(buf));
	    LOG_INF("status: 0x%X 0x%X; %s", (*status).bytes[0], (*status).bytes[1], buf);
	}else
	{
	    LOG_ERR("status: failed with %d %s", status.error(), strerror(status.error()));
	}
    }

    {
	auto apm_err = epeas::aem1392x_get_apm_error(aem13921_dev);
	if (apm_err)
	{
	    LOG_INF("apm error: 0x%X", apm_err->byte);
	}
	else
	{
	    LOG_ERR("apm error: failed with %d %s", apm_err.error(), strerror(apm_err.error()));
	}
    }

    {
	auto apm_5v = epeas::aem1392x_get_apm_ch5v(aem13921_dev);
	if (apm_5v)
	{
	    LOG_INF("apm 5v: %d", apm_5v->value);
	}
	else
	{
	    LOG_ERR("apm 5v: failed with %d %s", apm_5v.error(), strerror(apm_5v.error()));
	}
    }
    {
	auto apm_src1 = epeas::aem1392x_get_apm_src1(aem13921_dev);
	if (apm_src1)
	{
	    std::visit(
		overloaded{
		    [](const epeas::apm_counter_no_acc_t &v)
		    {
			LOG_INF("apm src1 cnt no acc: %d", v.value.counter);
		    },
		    [](const epeas::apm_counter_acc_t &v)
		    {
			LOG_INF("apm src1 cnt acc: %d:%d", v.value.offset, v.value.counter);
		    },
		    [](const epeas::apm_power_meter_acc_t &v)
		    {
			LOG_INF("apm src1 power: %d:%d", v.value.offset, v.value.power);
		    }
		},
		*apm_src1
	    );
	}
	else
	{
	    LOG_ERR("apm src1: failed with %d %s", apm_src1.error(), strerror(apm_src1.error()));
	}
    }
    {
	auto apm_src2 = epeas::aem1392x_get_apm_src2(aem13921_dev);
	if (apm_src2)
	{
	    std::visit(
		overloaded{
		    [](const epeas::apm_counter_no_acc_t &v)
		    {
			LOG_INF("apm src2 cnt no acc: %d", v.value.counter);
		    },
		    [](const epeas::apm_counter_acc_t &v)
		    {
			LOG_INF("apm src2 cnt acc: %d:%d", v.value.offset, v.value.counter);
		    },
		    [](const epeas::apm_power_meter_acc_t &v)
		    {
			LOG_INF("apm src2 power: %d:%d", v.value.offset, v.value.power);
		    }
		},
		*apm_src2
	    );
	}
	else
	{
	    LOG_ERR("apm src2: failed with %d %s", apm_src2.error(), strerror(apm_src2.error()));
	}
    }
    {
	auto apm_load = epeas::aem1392x_get_apm_load(aem13921_dev);
	if (apm_load)
	{
	    std::visit(
		overloaded{
		    [](const epeas::apm_counter_no_acc_t &v)
		    {
			LOG_INF("apm load cnt no acc: %d", v.value.counter);
		    },
		    [](const epeas::apm_counter_acc_t &v)
		    {
			LOG_INF("apm load cnt acc: %d:%d", v.value.offset, v.value.counter);
		    },
		    [](const epeas::apm_power_meter_acc_t &v)
		    {
			LOG_INF("apm load power: %d:%d", v.value.offset, v.value.power);
		    }
		},
		*apm_load
	    );
	}
	else
	{
	    LOG_ERR("apm load: failed with %d %s", apm_load.error(), strerror(apm_load.error()));
	}
    }
    {
	auto storage_v = epeas::aem1392x_get_storage_voltage(aem13921_dev);
	if (storage_v)
	{
	    LOG_INF("storage v: %.3f", (double)*storage_v);
	}
	else
	{
	    LOG_ERR("storage v: failed with %d %s", storage_v.error(), strerror(storage_v.error()));
	}
    }
    {
	auto src1_v = epeas::aem1392x_get_src_voltage(aem13921_dev, epeas::src_t::_1);
	if (src1_v)
	{
	    LOG_INF("src1 v: %.3f", (double)*src1_v);
	}
	else
	{
	    LOG_ERR("src1 v: failed with %d %s", src1_v.error(), strerror(src1_v.error()));
	}
    }
    {
	auto src2_v = epeas::aem1392x_get_src_voltage(aem13921_dev, epeas::src_t::_2);
	if (src2_v)
	{
	    LOG_INF("src2 v: %.3f", (double)*src2_v);
	}
	else
	{
	    LOG_ERR("src2 v: failed with %d %s", src2_v.error(), strerror(src2_v.error()));
	}
    }
    LOG_INF("<================AEM13921=================>");
}

static uint64_t total_load_power = 0;
static struct k_work aem_work;
static void aem_work_handler(struct k_work *work)
{
    //LOG_INF("AEM interrupt");
    auto state = epeas::aem1392x_get_irq_state(aem13921_dev);
    if (state)
    {
	auto s = *state;
	//LOG_INF("irq: 0x%X 0x%X", s.bytes[0], s.bytes[1]);
	if (s.bits.apm_done)
	{
	    auto print_apm = [](const auto &apm, const char *pPrefix){
		if (apm)
		{
		    std::visit(
			    overloaded{
				[&](const epeas::apm_counter_acc_t &rv)
				{
				    if (auto v = rv.get_value())
					LOG_INF("%s (counter acc): %llu", pPrefix, v);
				},
				[&](const epeas::apm_counter_no_acc_t &rv)
				{
				    if (rv.value.counter)
					LOG_INF("%s (counter no acc): %u", pPrefix, rv.value.counter);
				},
				[&](const epeas::apm_power_meter_acc_t &rv)
				{
				    if (auto v = rv.get_value())
					LOG_INF("%s (power): %llu", pPrefix, v);
				}
			    },
			    *apm
			);
		}else
		{
		    LOG_ERR("%s: failed with %d %s", pPrefix, apm.error(), strerror(apm.error()));
		}
	    };

	    {
		auto apm_load = epeas::aem1392x_get_apm_load(aem13921_dev);
		print_apm(apm_load, "APM Load");
	    }
	    {
		auto apm_src1 = epeas::aem1392x_get_apm_src1(aem13921_dev);
		print_apm(apm_src1, "APM Src1");
	    }
	    {
		auto apm_src2 = epeas::aem1392x_get_apm_src2(aem13921_dev);
		print_apm(apm_src2, "APM Src2");
	    }

	    auto apm_5v = epeas::aem1392x_get_apm_ch5v(aem13921_dev);
	    if (apm_5v)
	    {
		auto v = apm_5v->value;
		if (v)
		{
		    LOG_INF("APM 5v: %u", v);
		}
	    }else
	    {
		LOG_ERR("apm 5v: failed with %d %s", apm_5v.error(), strerror(apm_5v.error()));
	    }

	    auto apm_err = epeas::aem1392x_get_apm_error(aem13921_dev);
	    LOG_INF("APM Err: 0x%X", apm_err->byte);
	}
	if (s.bits.apm_error)
	{
	    auto apm_err = epeas::aem1392x_get_apm_error(aem13921_dev);
	    if (apm_err)
	    {
		LOG_INF("APM Err: 0x%X", apm_err->byte);
	    }else
	    {
		LOG_ERR("apm err: failed with %d %s", apm_err.error(), strerror(apm_err.error()));
	    }
	}
    }else
    {
	LOG_ERR("irq state: failed with %d %s", state.error(), strerror(state.error()));
    }
}

static void aem_isr(const struct device *dev, struct gpio_callback *cb, uint32_t pins)
{
    k_work_submit(&aem_work);
}

int main(void)
{
    //static_assert(atomic_state_t::is_always_lock_free);
    //disable_hw_wdt();

    //usb_uart::setup();
    //LOG_INF("aem13921 test: %d", aem13921_hello());
    soil::setup_task();
    pump::setup_task(on_pressure_measured);
    zb::setup();

    int err = settings_subsys_init();
    uint8_t v;
    err = epeas::aem1392x_get_version(aem13921_dev, &v);
    LOG_INF("aem13921 test: %d, %d", err, v);

    //epeas::aem1392x_configure_src_regulation_mppt(aem13921_dev, epeas::src_t::_0, {.ratio = epeas::mppt_ratio_t::_75, .wait = epeas::mppt_wait_t::_116, .period = epeas::mppt_period_t::_14895});
    //epeas::aem1392x_configure_src_regulation_voltage(aem13921_dev, epeas::src_t::_1, 0.5);
    auto res = epeas::aem1392x_get_src_regulation(aem13921_dev, epeas::src_t::_1);
    if (res)
    {
	auto const& v = *res;
	//auto *pmppt = std::get_if<epeas::src_mppt_cfg_t>(&v);
	//v.visit();
    }else
    {
	LOG_INF("aem13921 test@: %d", res.error());
    }

    k_work_init(&btn0_work, btn0_work_handler);
    k_work_init(&aem_work, aem_work_handler);

    err = gpio_pin_configure_dt(&btn0, GPIO_INPUT);
    if (err < 0) 
	LOG_INF("btn0 cfg: %d (%s)", err, strerror(err));
    err = gpio_pin_interrupt_configure_dt(&btn0, GPIO_INT_EDGE_TO_INACTIVE);
    if (err < 0)
	LOG_INF("btn0 int cfg: %d (%s)", err, strerror(err));
    gpio_init_callback(&btn0_cb_data, btn0_isr, BIT(btn0.pin));
    err = gpio_add_callback(btn0.port, &btn0_cb_data);
    if (err < 0)
	LOG_INF("btn0 cb: %d (%s)", err, strerror(err));

	//   err = gpio_pin_configure_dt(&aem13921_irq, GPIO_INPUT);
	//   if (err < 0) 
	//LOG_INF("aem13921_irq cfg: %d (%s)", err, strerror(err));
	//   err = gpio_pin_interrupt_configure_dt(&aem13921_irq, GPIO_INT_EDGE_TO_ACTIVE);
	//   gpio_init_callback(&aem_cb_data, aem_isr, BIT(aem13921_irq.pin));
	//   err = gpio_add_callback(aem13921_irq.port, &aem_cb_data);
	//   if (err < 0)
	//LOG_INF("aem13921_irq cb: %d (%s)", err, strerror(err));

	//   epeas::aem1392x_configure_buck(aem13921_dev, epeas::buck_cfg_t{.bits = {.vload = epeas::vload_t::_3_3V, .tmult = epeas::tmult_t::x4}});
	//   epeas::aem1392x_configure_apm(aem13921_dev, epeas::apm_cfg_t{.bits = {.src1 = true, .src2 = false, .buck = true, .ch5v = true, .mode = epeas::apm_mode_t::Counter, .win = epeas::apm_window_t::_233ms}});
	//   epeas::aem1392x_set_apm_accumulation_period(aem13921_dev, 10);
	//   {
	//epeas::irq_event_t irq_cfg;
	//irq_cfg.set_apm_done(true);
	//irq_cfg.set_apm_error(true);
	//epeas::aem1392x_configure_irq(aem13921_dev, irq_cfg);
	//   }
	//
	//   epeas::aem1392x_commit(aem13921_dev);
	//   aem_work_handler(nullptr);

	//   {
	//auto ctrl = epeas::aem1392x_get_ctrl_state(aem13921_dev);
	//LOG_INF("Ctrl: 0x%X", *ctrl);
	//   }
	//
	//   {
	//LOG_INF("IRQ Cfg:");
	//auto irq_cfg = epeas::aem1392x_get_irq_configuration(aem13921_dev);
	//if (irq_cfg)
	//{
	//    LOG_INF("byte0: 0x%X; byte1: 0x%X", irq_cfg.value().reg.bytes[0], irq_cfg.value().reg.bytes[1]);
	//}else
	//{
	//    LOG_ERR("Failed to get IRQ cfg: %d (%s)", irq_cfg.error(), strerror(irq_cfg.error()));
	//}
	//   }
	//   {
	//auto apm_cfg = epeas::aem1392x_get_apm_configuration(aem13921_dev);
	//LOG_INF("APM Cfg: 0x%X", apm_cfg->byte);
	//auto apm_win = epeas::aem1392x_get_apm_accumulation_period(aem13921_dev);
	//LOG_INF("APM Period: 0x%X", *apm_win);
	//   }

    printk("main\r\n");

    while (1) {
	if (dump_aem_info)
	{
	    dbg_aem13921();
	    dump_aem_info = false;
	}
	k_msleep(1000);
    }

    return 0;
}
