theorlangur/smart_watering/(commit log)

2026-09-26 builds and run with uart working
2026-09-26 removed 'led' from mcuboot's dts overlay
2026-09-27 added usb sensing pin description
2026-09-27 refactored uart00 pins definitions, moved usb-sensing to uart dtsi
2026-09-27 added logic of enabling/disabling UART depending on USB line state
2026-10-01 usb-uart logic
    usb sensing is working
    powering up/down is working
2026-10-01 declared soil sensors separately in DTS with own dedicated bindings
2026-10-01 first steps in bringing soil sensors to life
2026-10-02 soil sensors: reorganizing to use 'voltage-divider' device driver
2026-10-02 simplified soil sensor handling to a task only
    all thx to 'voltage-divider' device driver
2026-10-02 added logging for soil sensors
2026-10-09 added testing code for aem13921 driver
2026-10-11 added a basic implementation of a pump task
2026-10-18 this is a point where pump is working and a timer-based PWM too
2026-10-18 added soil sensor power state management + added APM load tracking in counter mode
2026-10-31 worked on pump and pressure logic
    added pressure/water level measuring logic
    also added true deactivation of "PWM" pin when the power regulator is disabled
2026-11-03 added cmd for measuring pressure
2026-11-03 added test code for pressure measuring
2026-11-03 fixed std::clamp usage
2026-11-03 reduced uart speed to 57600
2026-11-03 commented out stuff while looking for the uart issue
    [main.cpp]
